Lab-Partner-App/Low-cost-PotentioMeter-using-Arduino/WhatsApp Image 2024-11-09 at 18.15.29_eadaa60c.jpg

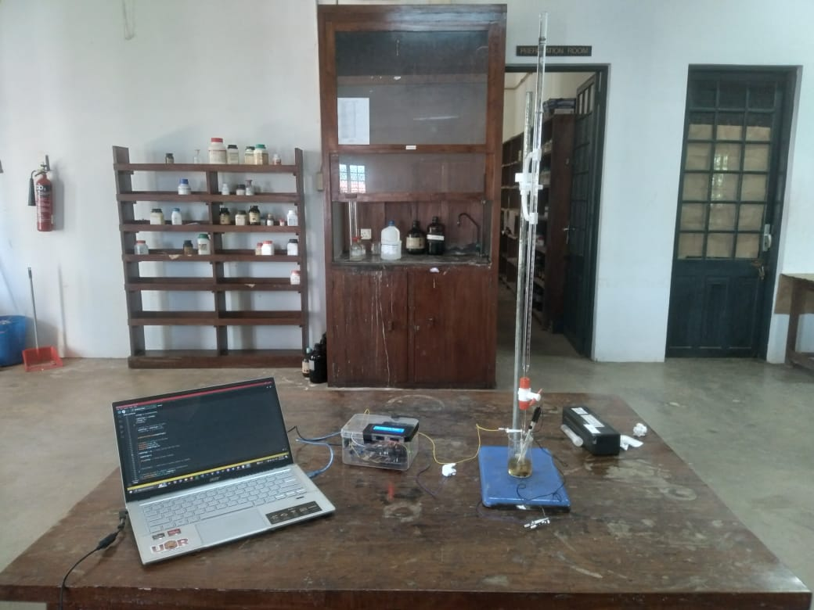
WhatsApp Image 2024-11-09 at 18.15.29_eadaa60c.jpg
