Lab-Partner-App/Low-cost-PotentioMeter-using-Arduino/WhatsApp Image 2024-11-09 at 18.15.28_9079781c.jpg

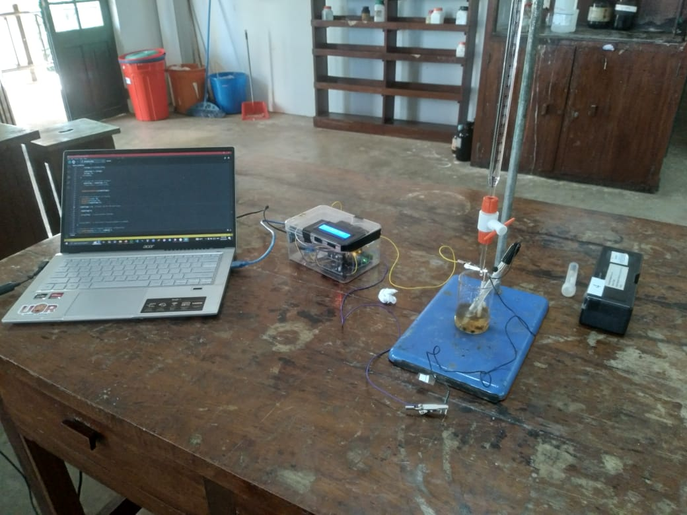
WhatsApp Image 2024-11-09 at 18.15.28_9079781c.jpg
