Lab-Partner-App/Low-cost-PotentioMeter-using-Arduino/WhatsApp Image 2024-11-09 at 18.16.40_ca7f934d.jpg

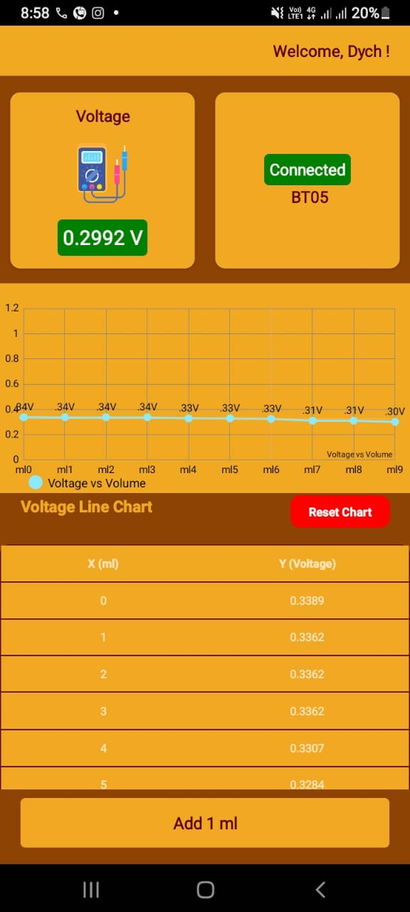
WhatsApp Image 2024-11-09 at 18.16.40_ca7f934d.jpg
