Lab-Partner-App/Low-cost-PotentioMeter-using-Arduino/Instrument calibrations.xlsx

 |  |  |  |  | Voltage Secsor Calibration
chart 1
(X±0) /no unit | (Y±0.0001)/V
96 | 2
184 | 4
267 | 6
354 | 8
440 | 10
524 | 12
608 | 14
693 | 16
781 | 18
864 | 20
950 | 22
chart 2
99 | 2
184 | 4
270 | 6
353 | 8
439 | 10
526 | 12
608 | 14
695 | 16
779 | 18
863 | 20
950 | 22
chart 3
100 | 2
182 | 4
267 | 6
355 | 8
439 | 10
525 | 12
610 | 14
695 | 16
781 | 18
864 | 20
951 | 22
chart 4
102 | 2
187 | 4
271 | 6
357 | 8
444 | 10
528 | 12
615 | 14
699 | 16
782 | 18
871 | 20
950 | 22 |  | m | c
 |  | chart1 | 0.0235 | 0.286
chart 5 |  | chart2 | 0.0235 | 0.3322
102 | 2 | chart3 | 0.0235 | 0.3057
187 | 4 | chart4 | 0.0235 | 0.4002
273 | 6 | chart5 | 0.0234 | 0.3843
356 | 8 | chart6 | 0.0235 | 0.3829
444 | 10 | Summation | 0.1409 | 2.0913
528 | 12 | Average | 0.02348333333 | 0.34855
614 | 14
699 | 16
784 | 18
870 | 20
955 | 22
chart 6
100 | 2
186 | 4
270 | 6
357 | 8
444 | 10
528 | 12
613 | 14
695 | 16
781 | 18
866 | 20
951 | 22
 |  |  |  |  | AD620 Instrumental Amplifier Calibartion
 |  | Voltage Error | (voltage ± 0.001) / V
 |  | Input Voltage(S+ & S-) | Output Voltage(Vout & GND)
 |  | 0.092 | 2.09
 |  | 0.094 | 2.13
 |  | 0.096 | 2.185
 |  | 0.098 | 2.213
 |  | 0.1 | 2.271
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
